pda/pda6502v2/docs/block.png

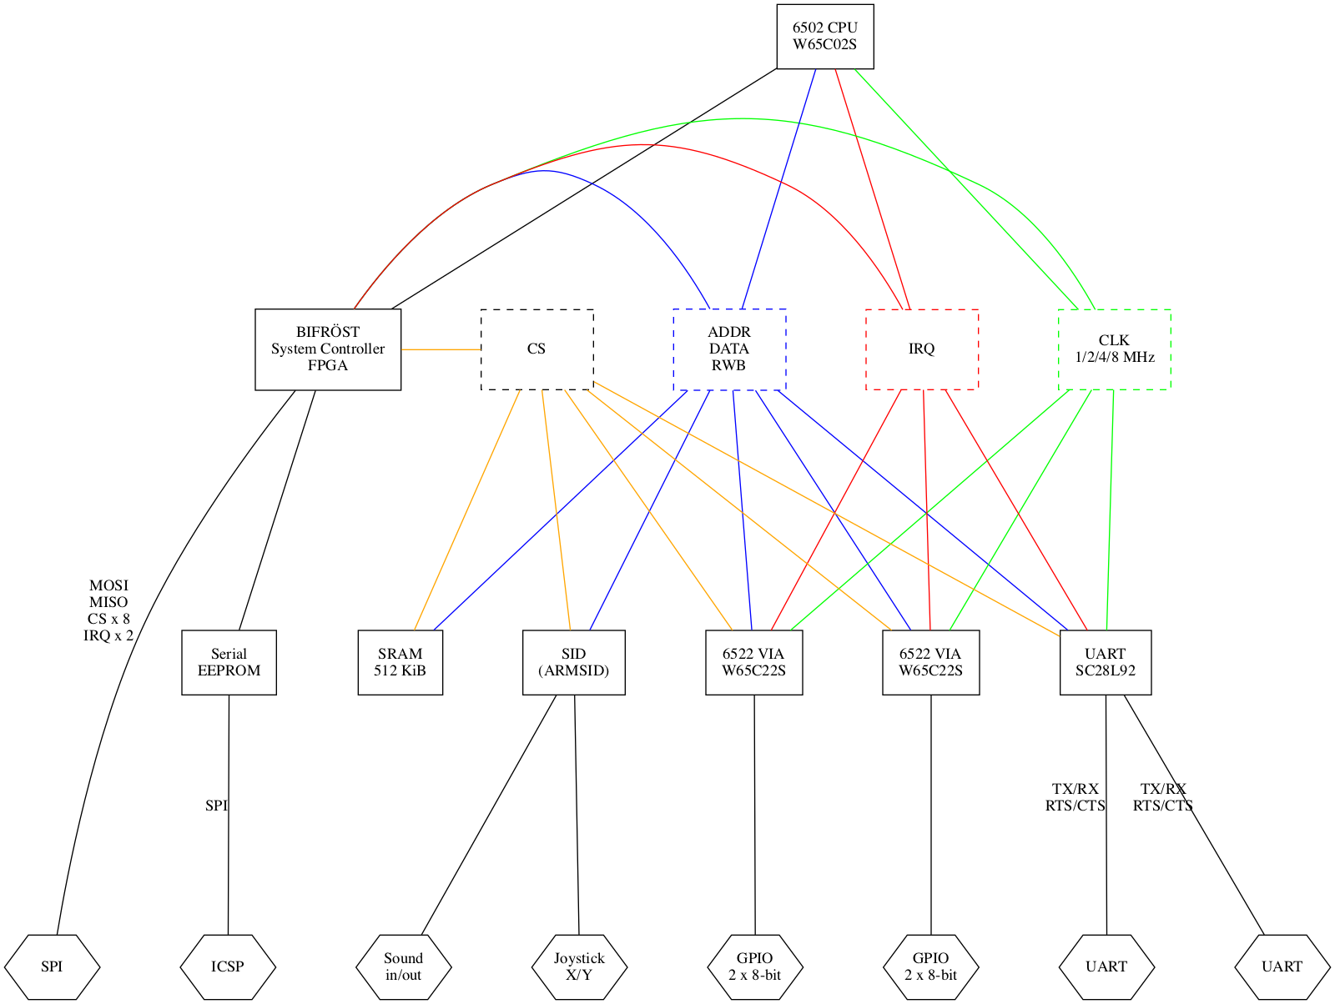
docs/block.png
