pda/pda6502v2/kicad/pda6502v2.kicad_pcb

## KiCad design kicad/pda6502v2.kicad_pcb (2023-10-16)

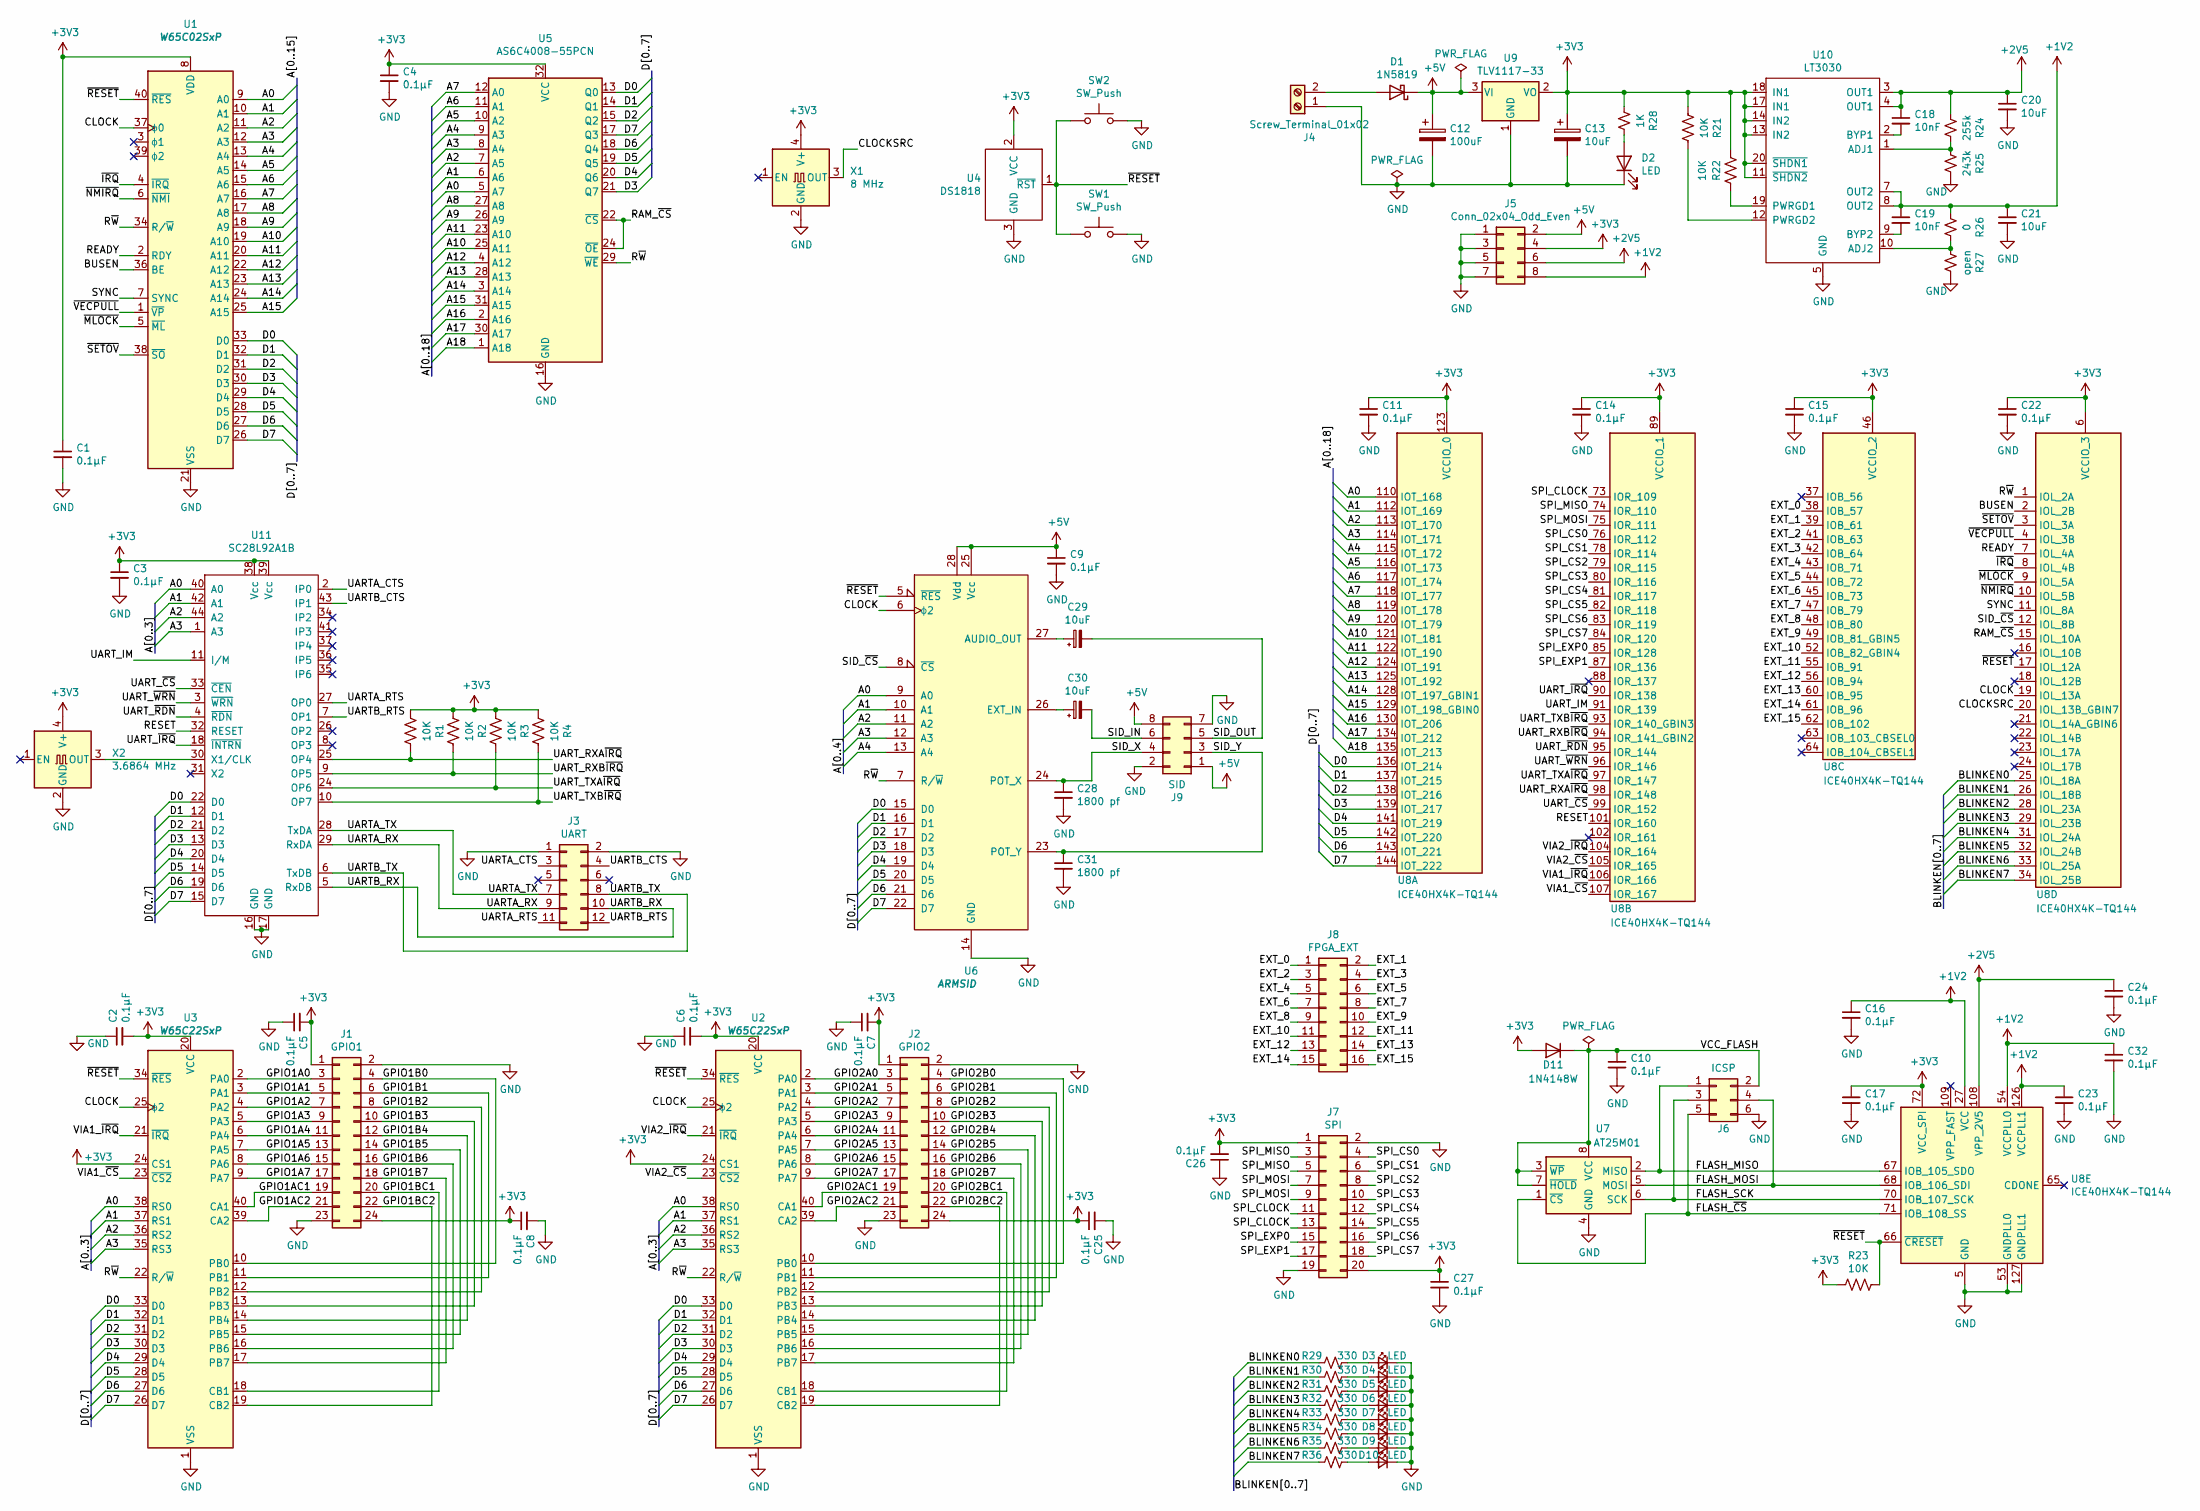
[picture p2: schematic pda6502v2.kicad_sch]

Parts:
C1, C2, C3, C4, C5, C6, C7, C8, C9, C10, C11, C14, C15, C16, C17, C22, C23, C24, C25, C26, C27, C32: 0.1μF; C_0805_2012Metric_Pad1.18x1.45mm_HandSolder
C12: 100uF; CP_Radial_D5.0mm_P2.00mm
C13: 10uF; CP_Radial_D5.0mm_P2.00mm
C18, C19: 10nF; C_0805_2012Metric_Pad1.18x1.45mm_HandSolder
C20, C21: 10uF; C_0805_2012Metric_Pad1.18x1.45mm_HandSolder
C28, C31: 1800 pf; C_0805_2012Metric_Pad1.18x1.45mm_HandSolder
C29, C30: 10uF; CP_EIA-3528-15_AVX-H_Pad1.50x2.35mm_HandSolder
D1: 1N5819; D_DO-41_SOD81_P10.16mm_Horizontal
D2: LED; LED_D3.0mm
D3, D4, D5, D6, D7, D8, D9, D10: LED; LED_0805_2012Metric_Pad1.15x1.40mm_HandSolder
D11: 1N4148W; D_SOD-123
J1: GPIO1; PinHeader_2x12_P2.54mm_Vertical
J2: GPIO2; PinHeader_2x12_P2.54mm_Vertical
J3: UART; PinHeader_2x06_P2.54mm_Vertical
J4: Screw_Terminal_01x02; TerminalBlock_Phoenix_MPT-0,5-2-2.54_1x02_P2.54mm_Horizontal
J5: Conn_02x04_Odd_Even; PinHeader_2x04_P2.54mm_Vertical
J6: ICSP; PinHeader_2x03_P2.54mm_Vertical
J7: SPI; PinHeader_2x10_P2.54mm_Vertical
J8: FPGA_EXT; PinHeader_2x08_P2.54mm_Vertical
J9: SID; PinHeader_2x04_P2.54mm_Vertical
R1, R2, R3, R4, R21, R22, R23: 10K; R_0805_2012Metric_Pad1.20x1.40mm_HandSolder
R24: 255k; R_0805_2012Metric_Pad1.20x1.40mm_HandSolder
R25: 243k; R_0805_2012Metric_Pad1.20x1.40mm_HandSolder
R26: 0; R_0805_2012Metric_Pad1.20x1.40mm_HandSolder
R27: open; R_0805_2012Metric_Pad1.20x1.40mm_HandSolder
R28: 1K; R_0805_2012Metric_Pad1.20x1.40mm_HandSolder
R29, R30, R31, R32, R33, R34, R35, R36: 330; R_0805_2012Metric_Pad1.20x1.40mm_HandSolder
SW1: SW_Push; SW_PUSH_6mm_H5mm
SW2: SW_Push; PinHeader_1x02_P2.54mm_Vertical
U1: W65C02SxP; DIP-40_W15.24mm
U2, U3: W65C22SxP; DIP-40_W15.24mm
U4: DS1818; SOT-23_Handsoldering
U5: AS6C4008-55PCN; DIP-32_W15.24mm
U6: ARMSID; DIP-28_W15.24mm_Socket
U7: AT25M01; SOIC-8_3.9x4.9mm_P1.27mm
U8: ICE40HX4K-TQ144; TQFP-144_20x20mm_P0.5mm
U9: TLV1117-33; SOT-223
U10: LT3030; HTSSOP-20-1EP_4.4x6.5mm_P0.65mm_EP2.85x4mm
U11: SC28L92A1B; PQFP-44_10x10mm_P0.8mm
X1: 8 MHz; Oscillator_SMD_EuroQuartz_XO53-4Pin_5.0x3.2mm
X2: 3.6864 MHz; Oscillator_SMD_EuroQuartz_XO53-4Pin_5.0x3.2mm

Connections:
+1V2: C16.1, C19.1, C21.1, C23.1, C32.1, J5.8, R26.2, U8.27 (VCC), U8.40 (VCC), U8.54 (VCCPLL0), U8.92 (VCC), U8.111 (VCC), U8.126 (VCCPLL1), U10.7 (OUT2), U10.8 (OUT2)
+2V5: C18.1, C20.1, C24.1, J5.6, R24.2, U8.108 (VPP_2V5), U10.3 (OUT1), U10.4 (OUT1)
+5V: C9.1, C12.1, D1.1 (K), J5.2, J9.1, J9.8, U6.25 (Vcc), U6.28 (Vdd), U9.3 (VI)
/A0: U1.9 (A0), U2.38 (RS0), U3.38 (RS0), U5.5 (A7), U6.9 (A0), U8.110 (IOT_168), U11.40 (A0)
/A1: U1.10 (A1), U2.37 (RS1), U3.37 (RS1), U5.6 (A6), U6.10 (A1), U8.112 (IOT_169), U11.42 (A1)
/A2: U1.11 (A2), U2.36 (RS2), U3.36 (RS2), U5.7 (A5), U6.11 (A2), U8.113 (IOT_170), U11.44 (A2)
/A3: U1.12 (A3), U2.35 (RS3), U3.35 (RS3), U5.8 (A4), U6.12 (A3), U8.114 (IOT_171), U11.1 (A3)
/A4: U1.13 (A4), U5.9 (A3), U6.13 (A4), U8.115 (IOT_172)
/A5: U1.14 (A5), U5.10 (A2), U8.116 (IOT_173)
/A6: U1.15 (A6), U5.11 (A1), U8.117 (IOT_174)
/A7: U1.16 (A7), U5.12 (A0), U8.118 (IOT_177)
/A8: U1.17 (A8), U5.27 (A8), U8.119 (IOT_178)
/A9: U1.18 (A9), U5.26 (A9), U8.120 (IOT_179)
/A10: U1.19 (A10), U5.25 (A11), U8.121 (IOT_181)
/A11: U1.20 (A11), U5.23 (A10), U8.122 (IOT_190)
/A12: U1.22 (A12), U5.4 (A12), U8.124 (IOT_191)
/A13: U1.23 (A13), U5.28 (A13), U8.125 (IOT_192)
/A14: U1.24 (A14), U5.3 (A14), U8.128 (IOT_197_GBIN1)
/A15: U1.25 (A15), U5.31 (A15), U8.129 (IOT_198_GBIN0)
/A16: U5.2 (A16), U8.130 (IOT_206)
/A17: U5.30 (A17), U8.134 (IOT_212)
/A18: U5.1 (A18), U8.135 (IOT_213)
/BLINKEN0: R29.2, U8.25 (IOL_18A)
/BLINKEN1: R30.2, U8.26 (IOL_18B)
/BLINKEN2: R31.2, U8.28 (IOL_23A)
/BLINKEN3: R32.2, U8.29 (IOL_23B)
/BLINKEN4: R33.2, U8.31 (IOL_24A)
/BLINKEN5: R34.2, U8.32 (IOL_24B)
/BLINKEN6: R35.2, U8.33 (IOL_25A)
/BLINKEN7: R36.2, U8.34 (IOL_25B)
/BUSEN: U1.36 (BE), U8.2 (IOL_2B)
/CLOCK: U1.37 (ϕ0), U2.25 (ϕ2), U3.25 (ϕ2), U6.6 (ϕ2), U8.19 (IOL_13A)
/CLOCKSRC: U8.20 (IOL_13B_GBIN7), X1.3 (OUT)
/D0: U1.33 (D0), U2.33 (D0), U3.33 (D0), U5.13 (Q0), U6.15 (D0), U8.136 (IOT_214), U11.22 (D0)
/D1: U1.32 (D1), U2.32 (D1), U3.32 (D1), U5.14 (Q1), U6.16 (D1), U8.137 (IOT_215), U11.12 (D1)
/D2: U1.31 (D2), U2.31 (D2), U3.31 (D2), U5.15 (Q2), U6.17 (D2), U8.138 (IOT_216), U11.21 (D2)
/D3: U1.30 (D3), U2.30 (D3), U3.30 (D3), U5.21 (Q7), U6.18 (D3), U8.139 (IOT_217), U11.13 (D3)
/D4: U1.29 (D4), U2.29 (D4), U3.29 (D4), U5.20 (Q6), U6.19 (D4), U8.141 (IOT_219), U11.20 (D4)
/D5: U1.28 (D5), U2.28 (D5), U3.28 (D5), U5.19 (Q5), U6.20 (D5), U8.142 (IOT_220), U11.14 (D5)
/D6: U1.27 (D6), U2.27 (D6), U3.27 (D6), U5.18 (Q4), U6.21 (D6), U8.143 (IOT_221), U11.19 (D6)
/D7: U1.26 (D7), U2.26 (D7), U3.26 (D7), U5.17 (Q3), U6.22 (D7), U8.144 (IOT_222), U11.15 (D7)
/EXT_0: J8.1, U8.38 (IOB_57)
/EXT_1: J8.2, U8.39 (IOB_61)
/EXT_2: J8.3, U8.41 (IOB_63)
/EXT_3: J8.4, U8.42 (IOB_64)
/EXT_4: J8.5, U8.43 (IOB_71)
/EXT_5: J8.6, U8.44 (IOB_72)
/EXT_6: J8.7, U8.45 (IOB_73)
/EXT_7: J8.8, U8.47 (IOB_79)
/EXT_8: J8.9, U8.48 (IOB_80)
/EXT_9: J8.10, U8.49 (IOB_81_GBIN5)
/EXT_10: J8.11, U8.52 (IOB_82_GBIN4)
/EXT_11: J8.12, U8.55 (IOB_91)
/EXT_12: J8.13, U8.56 (IOB_94)
/EXT_13: J8.14, U8.60 (IOB_95)
/EXT_14: J8.15, U8.61 (IOB_96)
/EXT_15: J8.16, U8.62 (IOB_102)
/FLASH_MISO: J6.1, U7.2 (MISO), U8.67 (IOB_105_SDO)
/FLASH_MOSI: J6.4, U7.5 (MOSI), U8.68 (IOB_106_SDI)
/FLASH_SCK: J6.3, U7.6 (SCK), U8.70 (IOB_107_SCK)
/FLASH_~CS: J6.5, U7.1 (~CS), U8.71 (IOB_108_SS)
/GPIO1A0: J1.3, U3.2 (PA0)
/GPIO1A1: J1.5, U3.3 (PA1)
/GPIO1A2: J1.7, U3.4 (PA2)
/GPIO1A3: J1.9, U3.5 (PA3)
/GPIO1A4: J1.11, U3.6 (PA4)
/GPIO1A5: J1.13, U3.7 (PA5)
/GPIO1A6: J1.15, U3.8 (PA6)
/GPIO1A7: J1.17, U3.9 (PA7)
/GPIO1AC1: J1.19, U3.40 (CA1)
/GPIO1AC2: J1.21, U3.39 (CA2)
/GPIO1B0: J1.4, U3.10 (PB0)
/GPIO1B1: J1.6, U3.11 (PB1)
/GPIO1B2: J1.8, U3.12 (PB2)
/GPIO1B3: J1.10, U3.13 (PB3)
/GPIO1B4: J1.12, U3.14 (PB4)
/GPIO1B5: J1.14, U3.15 (PB5)
/GPIO1B6: J1.16, U3.16 (PB6)
/GPIO1B7: J1.18, U3.17 (PB7)
/GPIO1BC1: J1.20, U3.18 (CB1)
/GPIO1BC2: J1.22, U3.19 (CB2)
/GPIO2A0: J2.3, U2.2 (PA0)
/GPIO2A1: J2.5, U2.3 (PA1)
/GPIO2A2: J2.7, U2.4 (PA2)
/GPIO2A3: J2.9, U2.5 (PA3)
/GPIO2A4: J2.11, U2.6 (PA4)
/GPIO2A5: J2.13, U2.7 (PA5)
/GPIO2A6: J2.15, U2.8 (PA6)
/GPIO2A7: J2.17, U2.9 (PA7)
/GPIO2AC1: J2.19, U2.40 (CA1)
/GPIO2AC2: J2.21, U2.39 (CA2)
/GPIO2B0: J2.4, U2.10 (PB0)
/GPIO2B1: J2.6, U2.11 (PB1)
/GPIO2B2: J2.8, U2.12 (PB2)
/GPIO2B3: J2.10, U2.13 (PB3)
/GPIO2B4: J2.12, U2.14 (PB4)
/GPIO2B5: J2.14, U2.15 (PB5)
/GPIO2B6: J2.16, U2.16 (PB6)
/GPIO2B7: J2.18, U2.17 (PB7)
/GPIO2BC1: J2.20, U2.18 (CB1)
/GPIO2BC2: J2.22, U2.19 (CB2)
/RAM_~CS: U5.22 (~CS), U5.24 (~OE), U8.15 (IOL_10A)
/READY: U1.2 (RDY), U8.7 (IOL_4A)
/RESET: U8.101 (IOR_160), U11.32 (RESET)
/R~W: U1.34 (R/~W), U2.22 (R/~W), U3.22 (R/~W), U5.29 (~WE), U6.7 (R/~W), U8.1 (IOL_2A)
/SID_IN: C30.2, J9.6
/SID_OUT: C29.2, J9.5
/SID_X: C28.1, J9.4, U6.24 (POT_X)
/SID_Y: C31.1, J9.3, U6.23 (POT_Y)
/SID_~CS: U6.8 (~CS), U8.12 (IOL_8B)
/SPI_CLOCK: J7.11, J7.13, U8.73 (IOR_109)
/SPI_CS0: J7.4, U8.76 (IOR_112)
/SPI_CS1: J7.6, U8.78 (IOR_114)
/SPI_CS2: J7.8, U8.79 (IOR_115)
/SPI_CS3: J7.10, U8.80 (IOR_116)
/SPI_CS4: J7.12, U8.81 (IOR_117)
/SPI_CS5: J7.14, U8.82 (IOR_118)
/SPI_CS6: J7.16, U8.83 (IOR_119)
/SPI_CS7: J7.18, U8.84 (IOR_120)
/SPI_EXP0: J7.15, U8.85 (IOR_128)
/SPI_EXP1: J7.17, U8.87 (IOR_136)
/SPI_MISO: J7.3, J7.5, U8.74 (IOR_110)
/SPI_MOSI: J7.7, J7.9, U8.75 (IOR_111)
/SYNC: U1.7 (SYNC), U8.11 (IOL_8A)
/UARTA_CTS: J3.3, U11.2 (IP0)
/UARTA_RTS: J3.11, U11.27 (OP0)
/UARTA_RX: J3.9, U11.29 (RxDA)
/UARTA_TX: J3.7, U11.28 (TxDA)
/UARTB_CTS: J3.4, U11.43 (IP1)
/UARTB_RTS: J3.12, U11.7 (OP1)
/UARTB_RX: J3.10, U11.5 (RxDB)
/UARTB_TX: J3.8, U11.6 (TxDB)
/UART_IM: U8.91 (IOR_139), U11.11 (I/M)
/UART_RXA~IRQ: R1.1, U8.98 (IOR_148), U11.25 (OP4)
/UART_RXB~IRQ: R2.1, U8.94 (IOR_141_GBIN2), U11.9 (OP5)
/UART_TXA~IRQ: R3.1, U8.97 (IOR_147), U11.24 (OP6)
/UART_TXB~IRQ: R4.1, U8.93 (IOR_140_GBIN3), U11.10 (OP7)
/UART_~CS: U8.99 (IOR_152), U11.33 (~CEN)
/UART_~IRQ: U8.90 (IOR_138), U11.18 (~INTRN)
/UART_~RDN: U8.95 (IOR_144), U11.4 (~RDN)
/UART_~WRN: U8.96 (IOR_146), U11.3 (~WRN)
/VCC_FLASH: C10.1, D11.1 (K), J6.2, U7.3 (~WP), U7.7 (~HOLD), U7.8 (VCC)
/VIA1_~CS: U3.23 (~CS2), U8.107 (IOR_167)
/VIA1_~IRQ: U3.21 (~IRQ), U8.106 (IOR_166)
/VIA2_~CS: U2.23 (~CS2), U8.105 (IOR_165)
/VIA2_~IRQ: U2.21 (~IRQ), U8.104 (IOR_164)
/~IRQ: U1.4 (~IRQ), U8.8 (IOL_4B)
/~MLOCK: U1.5 (~ML), U8.9 (IOL_5A)
/~NMIRQ: U1.6 (~NMI), U8.10 (IOL_5B)
/~RESET: R23.1, SW1.1, SW2.2, U1.40 (~RES), U2.34 (~RES), U3.34 (~RES), U4.1 (~RST), U6.5 (~RES), U8.17 (IOL_12A), U8.66 (~CRESET)
/~SETOV: U1.38 (~SO), U8.3 (IOL_3A)
/~VECPULL: U1.1 (~VP), U8.4 (IOL_3B)
unnamed: C18.2, U10.2 (BYP1)
unnamed: C19.2, U10.9 (BYP2)
unnamed: C29.1, U6.27 (AUDIO_OUT)
unnamed: C30.1, U6.26 (EXT_IN)
unnamed: D1.2 (A), J4.2
unnamed: D2.2 (A), R28.1
unnamed: D3.2 (A), R29.1
unnamed: D4.2 (A), R30.1
unnamed: D5.2 (A), R31.1
unnamed: D6.2 (A), R32.1
unnamed: D7.2 (A), R33.1
unnamed: D8.2 (A), R34.1
unnamed: D9.2 (A), R35.1
unnamed: D10.2 (A), R36.1
unnamed: R21.1, U10.12 (PWRGD2)
unnamed: R22.1, U10.19 (PWRGD1)
unnamed: R24.1, R25.2, U10.1 (ADJ1)
unnamed: R26.1, R27.2, U10.10 (ADJ2)
unnamed: U11.30 (X1/CLK), X2.3 (OUT)

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
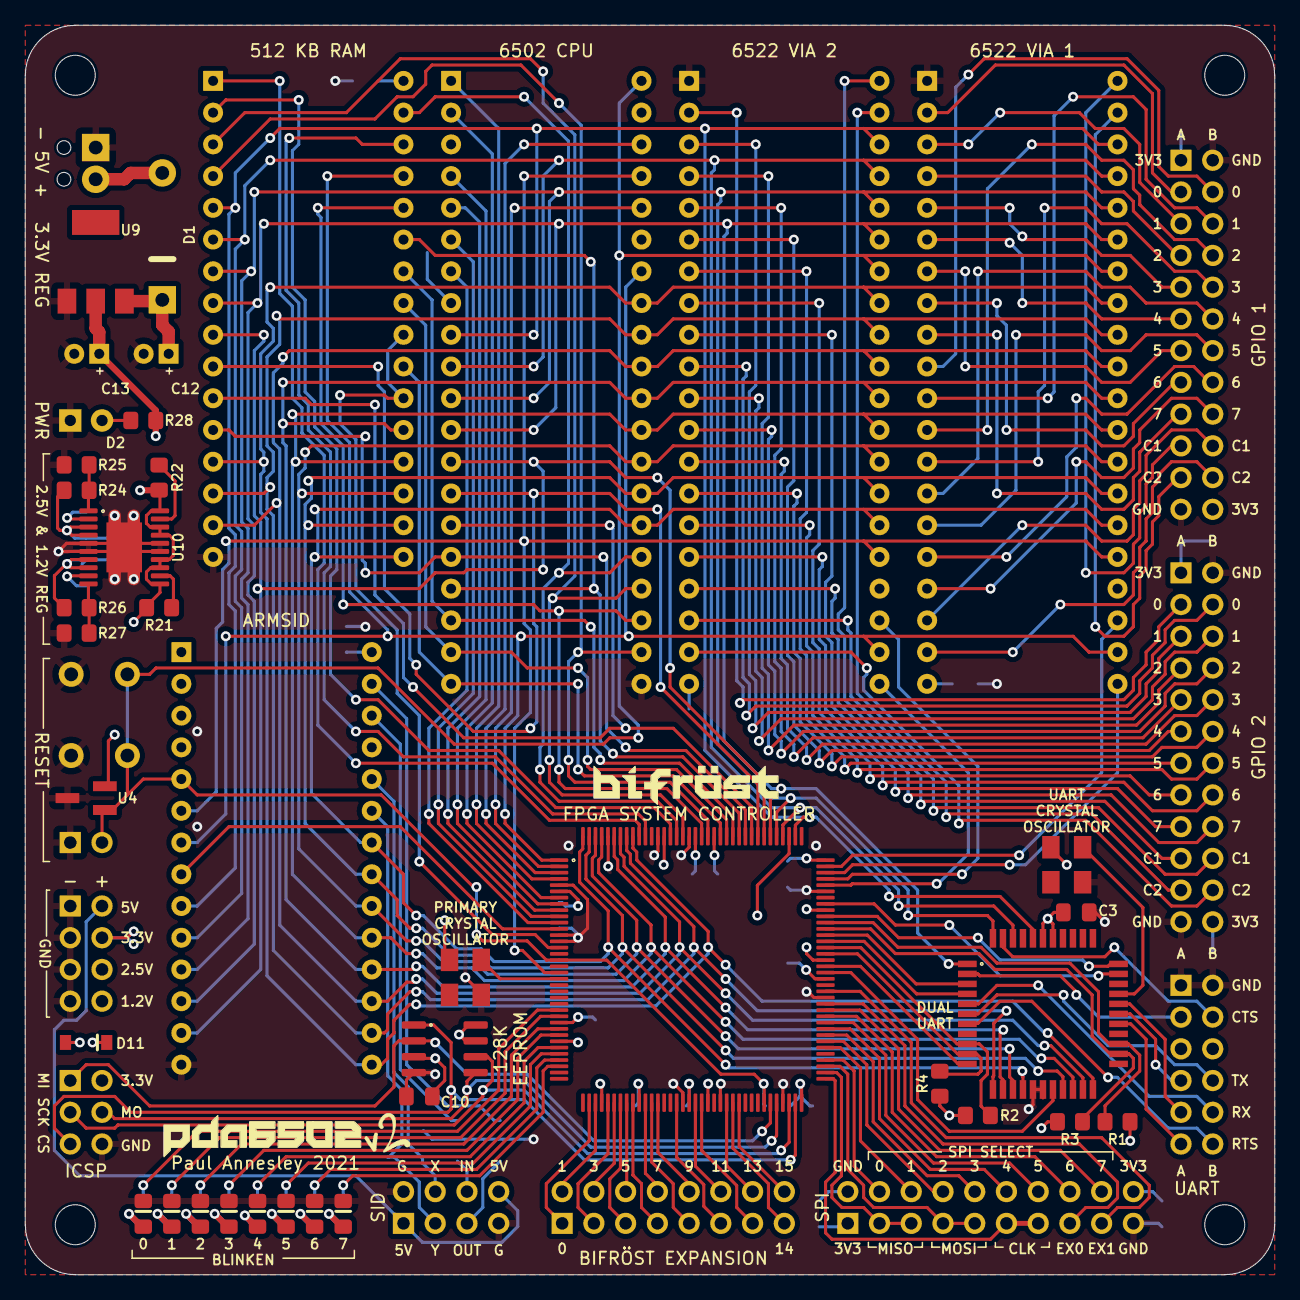
[picture p3: board pda6502v2.kicad_pcb from above]

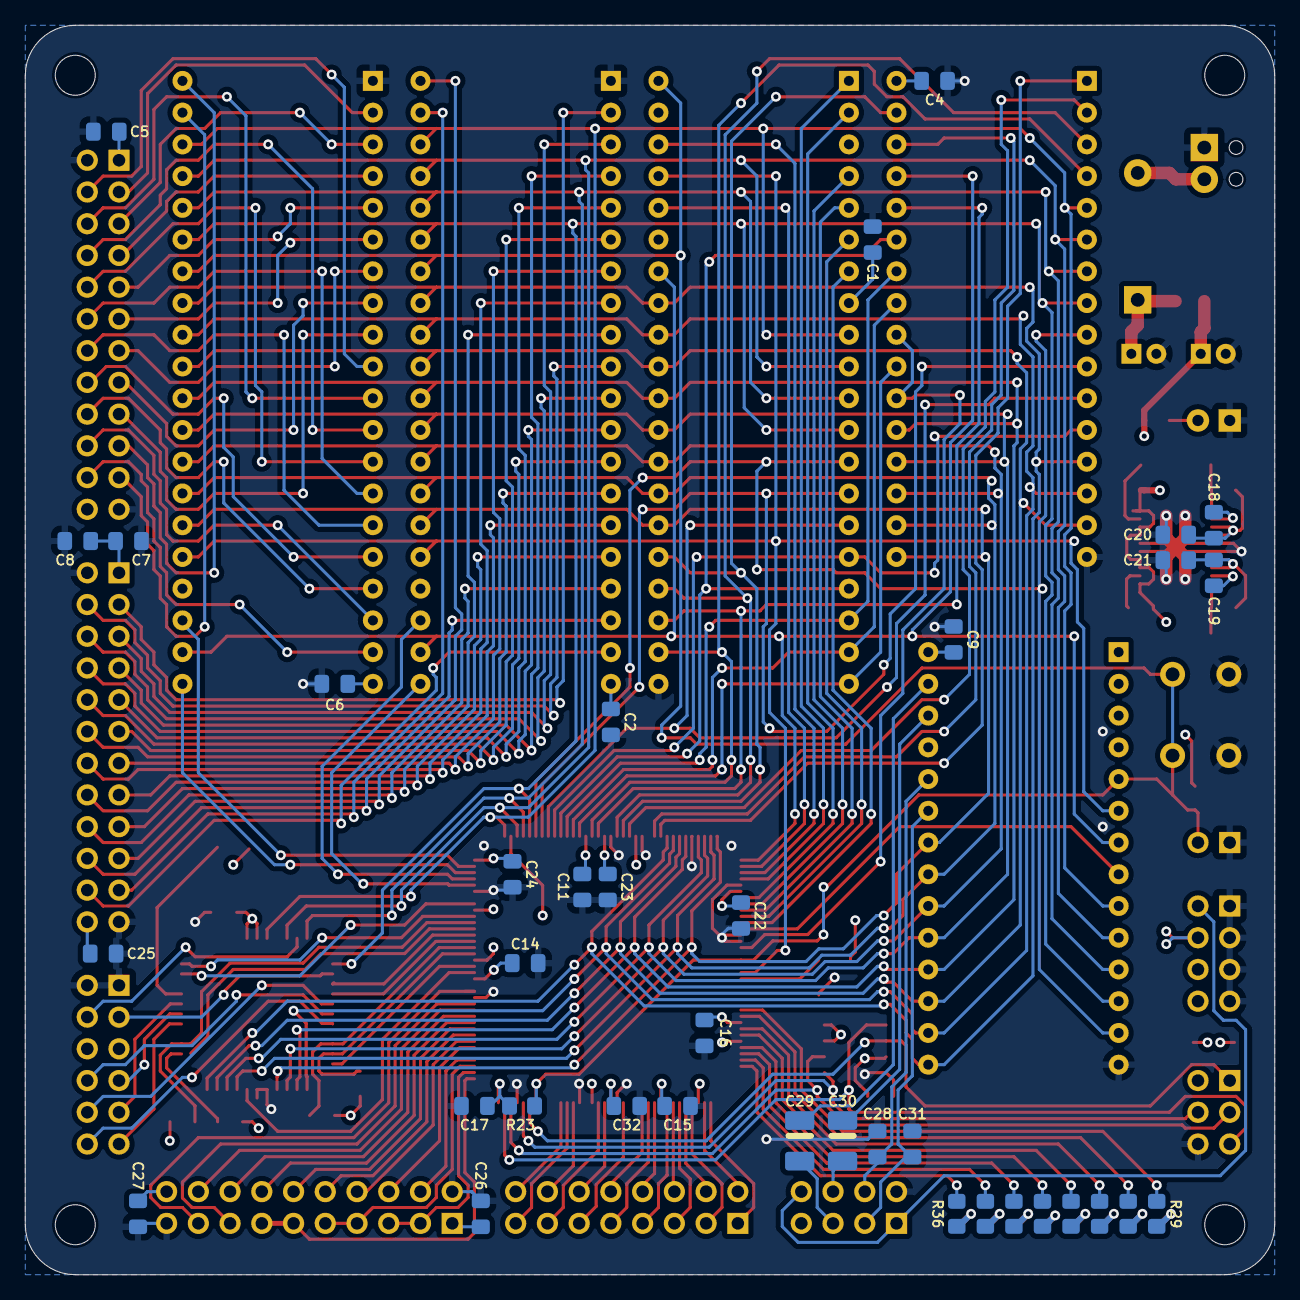
[picture p4: board pda6502v2.kicad_pcb from below]

Board: 4 copper layers, 100.0 x 100.0 mm, 87 parts (37 on the bottom side), 173 nets.
