pda/pda6502v2/emu/src/asm.rs

use std::collections::HashMap;
use std::fmt;

use crate::isa;
use crate::isa::{AddressMode, Mnemonic, OpValue, Opcode};

#[cfg(test)]
mod tests {
    use super::*;

    #[test]
    fn it_assembles_single_nop() {
        let mut asm = Assembler::new();
        assert_eq!(asm.nop().assemble().unwrap(), vec![0xEA]);
    }

    #[test]
    fn it_assembles_tiny_program_with_absolute_operand() {
        let mut asm = Assembler::new();
        asm.nop().nop().jmp(Operand::Abs(Addr::Literal(0x1234)));
        println!("{}", asm);
        assert_eq!(asm.assemble().unwrap(), vec![0xEA, 0xEA, 0x4C, 0x34, 0x12]);
    }

    #[test]
    fn it_assembles_labels() {
        let mut asm = Assembler::new();
        asm.org(0x1000)
            .label("foo")
            .jmp(Operand::Abs(label("bar")))
            .label("bar")
            .jmp(Operand::Abs(label("foo")));
        println!("{}", asm);
        assert_eq!(
            asm.assemble().unwrap(),
            vec![0x4C, 0x03, 0x10, 0x4C, 0x00, 0x10]
        );
    }

    #[test]
    #[should_panic(expected = "IllegalAddressMode(Jmp, Relative)")]
    fn it_errors_on_illegal_address_mode() {
        let mut asm = Assembler::new();
        asm.jmp(Operand::Rel(BranchTarget::Offset(0)))
            .assemble()
            .unwrap();
    }

    #[test]
    fn it_branches_to_nearby_label() {
        let mut asm = Assembler::new();
        asm.org(0x1000)
            .label("foo")
            .bcc(Operand::Rel(branch("bar")))
            .nop()
            .label("bar")
            .bcc(Operand::Rel(branch("foo")));
        println!("{}", asm);
        assert_eq!(asm.assemble().unwrap(), vec![0x90, 0x01, 0xEA, 0x90, 0xFB]);
    }

    #[test]
    #[should_panic(expected = "RelativeAddressOutOfRange(-131)")]
    fn it_cannot_branch_to_distant_label() {
        let mut asm = Assembler::new();
        asm.org(0x2000).label("start");
        for _ in 0..43 {
            asm.jmp(Operand::Abs(val(0x0000))); // 129 bytes of program
        }
        asm.bcc(Operand::Rel(branch("start")));
        asm.assemble().unwrap();
    }

    #[test]
    fn it_lists_with_out_of_range_label() {
        let mut asm = Assembler::new();
        asm.org(0x2000).label("start");
        for _ in 0..43 {
            asm.jmp(Operand::Abs(val(0x0000))); // 129 bytes of program
        }
        asm.bcc(Operand::Rel(branch("start")));
        println!("{}", asm.listing().unwrap());
    }
}

pub struct Assembler {
    pub org: u16,
    lines: Vec<Line>,
    next_label: Option<String>,
    opcode_map: isa::OpcodeByMnemonicAndAddressMode,
}

impl Assembler {
    pub fn new() -> Assembler {
        Self {
            org: 0x0000,
            lines: Vec::new(),
            next_label: None,
            opcode_map: isa::OpcodeByMnemonicAndAddressMode::build(),
        }
    }

    // TODO: consistently use -> &mut Self everywhere
    pub fn org(&mut self, addr: u16) -> &mut Self {
        self.org = addr;
        self
    }

    pub fn label(&mut self, l: &str) -> &mut Self {
        self.next_label = Some(l.to_string());
        self
    }

    pub fn data(&mut self, d: Vec<u8>) -> &mut Self {
        self.lines.push(Line::Data(DataLine {
            label: self.next_label.take(),
            data: d,
        }));
        self
    }

    // ----------------------------------------
    // Instructions

    pub fn adc(&mut self, op: Operand) -> &mut Self {
        self.push_instruction(Mnemonic::Adc, op)
    }

    pub fn and(&mut self, op: Operand) -> &mut Self {
        self.push_instruction(Mnemonic::And, op)
    }

    pub fn asl(&mut self, op: Operand) -> &mut Self {
        self.push_instruction(Mnemonic::Asl, op)
    }

    pub fn bcc(&mut self, op: Operand) -> &mut Self {
        self.push_instruction(Mnemonic::Bcc, op)
    }

    pub fn bcs(&mut self, op: Operand) -> &mut Self {
        self.push_instruction(Mnemonic::Bcs, op)
    }

    pub fn beq(&mut self, op: Operand) -> &mut Self {
        self.push_instruction(Mnemonic::Beq, op)
    }

    pub fn bit(&mut self, op: Operand) -> &mut Self {
        self.push_instruction(Mnemonic::Bit, op)
    }

    pub fn bmi(&mut self, op: Operand) -> &mut Self {
        self.push_instruction(Mnemonic::Bmi, op)
    }

    pub fn bne(&mut self, op: Operand) -> &mut Self {
        self.push_instruction(Mnemonic::Bne, op)
    }

    pub fn bpl(&mut self, op: Operand) -> &mut Self {
        self.push_instruction(Mnemonic::Bpl, op)
    }

    pub fn brk(&mut self) -> &mut Self {
        self.push_instruction(Mnemonic::Brk, Operand::Impl)
    }

    pub fn bvc(&mut self, op: Operand) -> &mut Self {
        self.push_instruction(Mnemonic::Bvc, op)
    }

    pub fn bvs(&mut self, op: Operand) -> &mut Self {
        self.push_instruction(Mnemonic::Bvs, op)
    }

    pub fn clc(&mut self) -> &mut Self {
        self.push_instruction(Mnemonic::Clc, Operand::Impl)
    }

    pub fn cld(&mut self) -> &mut Self {
        self.push_instruction(Mnemonic::Cld, Operand::Impl)
    }

    pub fn cli(&mut self) -> &mut Self {
        self.push_instruction(Mnemonic::Cli, Operand::Impl)
    }

    pub fn clv(&mut self) -> &mut Self {
        self.push_instruction(Mnemonic::Clv, Operand::Impl)
    }

    pub fn cmp(&mut self, op: Operand) -> &mut Self {
        self.push_instruction(Mnemonic::Cmp, op)
    }

    pub fn cpx(&mut self, op: Operand) -> &mut Self {
        self.push_instruction(Mnemonic::Cpx, op)
    }

    pub fn cpy(&mut self, op: Operand) -> &mut Self {
        self.push_instruction(Mnemonic::Cpy, op)
    }

    pub fn dec(&mut self, op: Operand) -> &mut Self {
        self.push_instruction(Mnemonic::Dec, op)
    }

    pub fn dex(&mut self) -> &mut Self {
        self.push_instruction(Mnemonic::Dex, Operand::Impl)
    }

    pub fn dey(&mut self) -> &mut Self {
        self.push_instruction(Mnemonic::Dey, Operand::Impl)
    }

    pub fn eor(&mut self, op: Operand) -> &mut Self {
        self.push_instruction(Mnemonic::Eor, op)
    }

    pub fn inc(&mut self, op: Operand) -> &mut Self {
        self.push_instruction(Mnemonic::Inc, op)
    }

    pub fn inx(&mut self) -> &mut Self {
        self.push_instruction(Mnemonic::Inx, Operand::Impl)
    }

    pub fn iny(&mut self) -> &mut Self {
        self.push_instruction(Mnemonic::Iny, Operand::Impl)
    }

    pub fn jmp(&mut self, op: Operand) -> &mut Self {
        self.push_instruction(Mnemonic::Jmp, op)
    }

    pub fn jsr(&mut self, op: Operand) -> &mut Self {
        self.push_instruction(Mnemonic::Jsr, op)
    }

    pub fn lda(&mut self, op: Operand) -> &mut Self {
        self.push_instruction(Mnemonic::Lda, op)
    }

    pub fn ldx(&mut self, op: Operand) -> &mut Self {
        self.push_instruction(Mnemonic::Ldx, op)
    }

    pub fn ldy(&mut self, op: Operand) -> &mut Self {
        self.push_instruction(Mnemonic::Ldy, op)
    }

    pub fn lsr(&mut self, op: Operand) -> &mut Self {
        self.push_instruction(Mnemonic::Lsr, op)
    }

    pub fn nop(&mut self) -> &mut Self {
        self.push_instruction(Mnemonic::Nop, Operand::Impl)
    }

    pub fn ora(&mut self, op: Operand) -> &mut Self {
        self.push_instruction(Mnemonic::Ora, op)
    }

    pub fn pha(&mut self) -> &mut Self {
        self.push_instruction(Mnemonic::Pha, Operand::Impl)
    }

    pub fn php(&mut self) -> &mut Self {
        self.push_instruction(Mnemonic::Php, Operand::Impl)
    }

    pub fn pla(&mut self) -> &mut Self {
        self.push_instruction(Mnemonic::Pla, Operand::Impl)
    }

    pub fn plp(&mut self) -> &mut Self {
        self.push_instruction(Mnemonic::Plp, Operand::Impl)
    }

    pub fn rol(&mut self, op: Operand) -> &mut Self {
        self.push_instruction(Mnemonic::Rol, op)
    }

    pub fn ror(&mut self, op: Operand) -> &mut Self {
        self.push_instruction(Mnemonic::Ror, op)
    }

    pub fn rti(&mut self) -> &mut Self {
        self.push_instruction(Mnemonic::Rti, Operand::Impl)
    }

    pub fn rts(&mut self) -> &mut Self {
        self.push_instruction(Mnemonic::Rts, Operand::Impl)
    }

    pub fn sbc(&mut self, op: Operand) -> &mut Self {
        self.push_instruction(Mnemonic::Sbc, op)
    }

    pub fn sec(&mut self) -> &mut Self {
        self.push_instruction(Mnemonic::Sec, Operand::Impl)
    }

    pub fn sed(&mut self) -> &mut Self {
        self.push_instruction(Mnemonic::Sed, Operand::Impl)
    }

    pub fn sei(&mut self) -> &mut Self {
        self.push_instruction(Mnemonic::Sei, Operand::Impl)
    }

    pub fn sta(&mut self, op: Operand) -> &mut Self {
        self.push_instruction(Mnemonic::Sta, op)
    }

    pub fn stx(&mut self, op: Operand) -> &mut Self {
        self.push_instruction(Mnemonic::Stx, op)
    }

    pub fn sty(&mut self, op: Operand) -> &mut Self {
        self.push_instruction(Mnemonic::Sty, op)
    }

    pub fn tax(&mut self) -> &mut Self {
        self.push_instruction(Mnemonic::Tax, Operand::Impl)
    }

    pub fn tay(&mut self) -> &mut Self {
        self.push_instruction(Mnemonic::Tay, Operand::Impl)
    }

    pub fn tsx(&mut self) -> &mut Self {
        self.push_instruction(Mnemonic::Tsx, Operand::Impl)
    }

    pub fn txa(&mut self) -> &mut Self {
        self.push_instruction(Mnemonic::Txa, Operand::Impl)
    }

    pub fn txs(&mut self) -> &mut Self {
        self.push_instruction(Mnemonic::Txs, Operand::Impl)
    }

    pub fn tya(&mut self) -> &mut Self {
        self.push_instruction(Mnemonic::Tya, Operand::Impl)
    }

    // ----------------------------------------

    pub fn assemble(&self) -> Result<Vec<u8>, Error> {
        let mut bin: Vec<u8> = Vec::new();

        let labtab = self.build_label_table();

        let mut addr = self.org;
        for line in self.lines.iter() {
            addr += line.size();
            match line {
                Line::Instruction(line) => {
                    bin.push(line.instruction?.code);
                    match op_value(addr, &line.operand, &labtab)? {
                        OpValue::None => {}
                        OpValue::U8(x) => bin.push(x),
                        OpValue::U16(x) => {
                            bin.push(x as u8);
                            bin.push((x >> 8) as u8);
                        }
                    };
                }
                Line::Data(line) => bin.extend(&line.data),
            }
        }
        Ok(bin)
    }

    pub fn listing(&self) -> Result<String, Error> {
        use std::fmt::Write;
        let mut f = String::new();

        let labtab = self.build_label_table();

        writeln!(f, "* = ${:04X}", self.org)?;
        let mut addr = self.org;
        for line in self.lines.iter() {
            let base_addr = addr;
            addr += line.size();
            line.fmt(&mut f, base_addr, addr, &labtab)?;
        }
        Ok(f)
    }

    pub fn print_listing(&mut self) -> &mut Self {
        println!("{}", self.listing().unwrap());
        self
    }

    fn push_instruction(&mut self, mnemonic: Mnemonic, op: Operand) -> &mut Self {
        self.lines.push(Line::Instruction(InstructionLine {
            label: self.next_label.take(),
            instruction: self.opcode_map.get(mnemonic, op.mode()).map_err(Into::into),
            operand: op,
            comment: None,
        }));
        self
    }

    fn build_label_table(&self) -> HashMap<&str, u16> {
        let mut labtab: HashMap<&str, u16> = HashMap::new();
        let mut addr = self.org;
        for line in self.lines.iter() {
            if let Some(l) = &line.label() {
                labtab.insert(l, addr);
            }
            addr += line.size();
        }
        labtab
    }
}

impl fmt::Display for Assembler {
    fn fmt(&self, f: &mut fmt::Formatter<'_>) -> fmt::Result {
        write!(f, "{}", self.listing().unwrap())
    }
}

impl fmt::Display for Operand {
    fn fmt(&self, f: &mut fmt::Formatter<'_>) -> fmt::Result {
        use Operand::*;
        match self {
            A => write!(f, "A"),
            Abs(x) => write!(f, "{}", x),
            AbsX(x) => write!(f, "{},X", x),
            AbsY(x) => write!(f, "{},Y", x),
            Imm(x) => write!(f, "${:02X}", x),
            Impl => Ok(()),
            Ind(x) => write!(f, "({})", x),
            XInd(x) => write!(f, "(${:02X},X)", x),
            IndY(x) => write!(f, "(${:02X}),Y", x),
            Rel(x) => write!(f, "{}", x),
            Z(x) => write!(f, "${:02X}", x),
            ZX(x) => write!(f, "${:02X},X", x),
            ZY(x) => write!(f, "${:02X},Y", x),
        }
    }
}

impl fmt::Display for Addr {
    fn fmt(&self, f: &mut fmt::Formatter<'_>) -> fmt::Result {
        match self {
            Addr::Literal(a) => write!(f, "${:04X}", a),
            Addr::Label(l) => write!(f, "{}", l),
        }
    }
}

impl fmt::Display for BranchTarget {
    fn fmt(&self, f: &mut fmt::Formatter<'_>) -> fmt::Result {
        match self {
            BranchTarget::Offset(x) => write!(f, "{}", x),
            BranchTarget::Label(l) => write!(f, "{}", l),
        }
    }
}

#[derive(Debug)]
pub enum Line {
    Instruction(InstructionLine),
    Data(DataLine),
}

#[derive(Debug)]
pub struct InstructionLine {
    pub label: Option<String>,
    pub instruction: Result<Opcode, Error>,
    pub operand: Operand,
    pub comment: Option<String>,
}

#[derive(Debug)]
pub struct DataLine {
    label: Option<String>,
    data: Vec<u8>,
}

impl Line {
    fn label(&self) -> &Option<String> {
        match self {
            Line::Instruction(line) => &line.label,
            Line::Data(line) => &line.label,
        }
    }

    fn size(&self) -> u16 {
        match self {
            Line::Instruction(line) => line.operand.length() as u16 + 1,
            Line::Data(line) => line.data.len().try_into().unwrap(),
        }
    }

    pub fn fmt(
        &self,
        f: &mut String,
        base_addr: u16,
        addr: u16,
        labtab: &HashMap<&str, u16>,
    ) -> Result<(), Error> {
        use std::fmt::Write;

        match self {
            Line::Instruction(line) => {
                let instruction = line.instruction.unwrap();
                let mut err: Option<Error> = None;
                let ophex = match op_value(addr, &line.operand, &labtab) {
                    Ok(x) => match x {
                        OpValue::None => String::new(),
                        OpValue::U8(x) => format!("{:02X}", x),
                        OpValue::U16(x) => format!("{:02X} {:02X}", x & 0xFF, (x >> 8)),
                    },
                    Err(e) => {
                        err = Some(e);
                        format!("?? ??")
                    }
                };
                let label = match &line.label {
                    Some(label) => format!("{}:", label),
                    None => String::from(""),
                };
                let op_prefix = match instruction.mode {
                    AddressMode::Immediate => "#",
                    _ => "",
                };
                let err_string = match err {
                    Some(e) => format!(" ; {e:?}"),
                    None => String::from(""),
                };
                let comment = match &line.comment {
                    Some(c) => format!(" ; {c}"),
                    None => String::new(),
                };
                writeln!(
                    f,
                    "{:04X} | {:02X} {:5} | {:16} {} {}{}{}{}",
                    base_addr,
                    instruction.code,
                    ophex,
                    label,
                    instruction.mnemonic,
                    op_prefix,
                    line.operand,
                    err_string,
                    comment,
                )?;
            }
            Line::Data(line) => {
                let label = match &line.label {
                    Some(label) => format!("{}:", label),
                    None => String::from(""),
                };
                writeln!(f, "                  {:16}", label)?;
                let mut addr = base_addr;
                for linechunk in line.data.chunks(16) {
                    let hex = linechunk
                        .chunks(8)
                        .map(|half| {
                            half.iter()
                                .map(|x| format!("{:02X}", x))
                                .collect::<Vec<String>>()
                                .join(" ")
                        })
                        .collect::<Vec<String>>()
                        .join("  ");

                    let ascii: String = linechunk
                        .iter()
                        .map(|&x| if x >= 32 && x <= 126 { x as char } else { '.' })
                        .collect();

                    writeln!(f, "{:04X}  {:49} |{}|", addr, hex, ascii)?;

                    addr += linechunk.len() as u16;
                }
            }
        }

        Ok(())
    }
}

// Opcode Operands
#[derive(Debug)]
pub enum Operand {
    A,
    Abs(Addr),
    AbsX(Addr),
    AbsY(Addr),
    Imm(u8),
    Impl,
    Ind(Addr),
    XInd(u8),
    IndY(u8),
    Rel(BranchTarget),
    Z(u8),
    ZX(u8),
    ZY(u8),
}

impl Operand {
    fn mode(&self) -> AddressMode {
        match self {
            Operand::A => AddressMode::Accumulator,
            Operand::Abs(_) => AddressMode::Absolute,
            Operand::AbsX(_) => AddressMode::AbsoluteX,
            Operand::AbsY(_) => AddressMode::AbsoluteY,
            Operand::Imm(_) => AddressMode::Immediate,
            Operand::Impl => AddressMode::Implied,
            Operand::Ind(_) => AddressMode::Indirect,
            Operand::XInd(_) => AddressMode::XIndirect,
            Operand::IndY(_) => AddressMode::IndirectY,
            Operand::Rel(_) => AddressMode::Relative,
            Operand::Z(_) => AddressMode::Zeropage,
            Operand::ZX(_) => AddressMode::ZeropageX,
            Operand::ZY(_) => AddressMode::ZeropageY,
        }
    }

    fn length(&self) -> u16 {
        isa::operand_length(self.mode())
    }
}

#[derive(Debug)]
pub enum Addr {
    Literal(u16),
    Label(String),
}

// shorthand for a literal/numeric address, as opposed to a labelled address.
pub fn val(v: u16) -> Addr {
    Addr::Literal(v)
}

// shorthand for a labelled address, as opposed to a literal (numeric) address.
pub fn label(s: &str) -> Addr {
    Addr::Label(s.to_string())
}

#[derive(Debug)]
#[allow(unused)]
pub enum BranchTarget {
    Offset(i8),
    Label(String),
}

// shorthand for a nearby labelled branch target
pub fn branch(s: &str) -> BranchTarget {
    BranchTarget::Label(s.to_string())
}

#[derive(Debug, Clone, Copy)]
pub enum Error {
    IllegalAddressMode(Mnemonic, AddressMode),
    RelativeAddressOutOfRange(i16),
    LabelNotFound, // TODO: include label string
    Fmt(fmt::Error),
}

impl From<fmt::Error> for Error {
    fn from(err: fmt::Error) -> Self {
        Error::Fmt(err)
    }
}

impl From<isa::Error> for Error {
    fn from(err: isa::Error) -> Self {
        match err {
            isa::Error::IllegalAddressMode(m, am) => Error::IllegalAddressMode(m, am),
        }
    }
}

fn op_value(addr: u16, op: &Operand, labtab: &HashMap<&str, u16>) -> Result<OpValue, Error> {
    use Operand::*;
    match op {
        A | Impl => Ok(OpValue::None),
        Abs(x) | AbsX(x) | AbsY(x) | Ind(x) => match x {
            Addr::Literal(x) => Ok(OpValue::U16(*x)),
            Addr::Label(x) => match labtab.get(x.as_str()) {
                Some(addr) => Ok(OpValue::U16(*addr)),
                None => Err(Error::LabelNotFound),
            },
        },
        Rel(x) => match x {
            BranchTarget::Offset(x) => Ok(OpValue::U8(*x as u8)),
            BranchTarget::Label(x) => {
                let target_addr = match labtab.get(x.as_str()) {
                    Some(addr) => *addr,
                    None => return Err(Error::LabelNotFound),
                };
                let rel16: i16 = target_addr.wrapping_sub(addr) as i16;
                let rel8: i8 = match rel16.try_into() {
                    Ok(x) => x,
                    Err(_) => {
                        return Err(Error::RelativeAddressOutOfRange(rel16));
                    }
                };
                Ok(OpValue::U8(rel8 as u8))
            }
        },
        Imm(x) | XInd(x) | IndY(x) | Z(x) | ZX(x) | ZY(x) => Ok(OpValue::U8(*x)),
    }
}
