pda/pda6502v2/(commit log)

2017-03-19 hardware: new blank KiCad project.
    [pda6502v2.kicad_pcb, pda6502v2.sch]
2017-03-19 KiCad.gitignore from github/gitignore
2017-03-19 pda6502v2 KiCad library with SAMD21J18A-AU
2017-03-20 Xilinx CoolRunner-II XC2C64A VQ-44 CPLD in library.
    Based on Dangerous Prototypes' converted-from-Eagle KiCad lib.
2017-03-31 hardware: WIP: glue schematic (CPLD address decode).
    [glue.sch, pda6502v2.sch]
2017-04-10 hardware: delete WIP on VQ44 "glue" CPLD.
    [glue.sch, pda6502v2.sch]
2017-04-11 hardware: chipset schematic; XC2C128A-VQ100
    [chipset.sch, pda6502v2.sch]
2017-04-11 hardware: chipset hierarchical pins
    [chipset.sch, pda6502v2.sch]
2017-04-14 hardware: CPU sub-schematic.
    [chipset.sch, cpu.sch, pda6502v2.sch]
2017-04-28 hardware: schematic for 2 x 6522 VIA/GPIO.
    [chipset.sch, cpu.sch, gpio.sch, pda6502v2.sch]
2021-04-10 Delete WIP KiCad schematic from April 2017
    It had some nice starts, with heirarchical sheets for 6522 GPIO etc, but
    was based on CPLD rather than FPGA, and had issues with latest KiCad
    versions/libraries which aren't really worth resolving.
    [chipset.sch, cpu.sch, gpio.sch, pda6502v2.kicad_pcb, pda6502v2.sch]
2021-04-10 kicad: new empty project
    [pda6502v2.kicad_pcb, pda6502v2.sch]
2021-04-11 kicad/.gitignore from github/gitignore/KiCad.gitignore
2021-05-01 KiCad schematic has 6502, 6522, 2 x 32 KiB RAM.
    [pda6502v2.kicad_pcb, pda6502v2.sch]
2021-05-29 README updates; keeping up with changed during schematic capture etc.
2021-05-29 Lots of progress on schematic, some PCB part placement.
    [pda6502v2.kicad_pcb, pda6502v2.sch]
2021-06-03 WIP: remove PMOD. SMD LDO. Layout updates.
    [pda6502v2.kicad_pcb, pda6502v2.sch]
2021-06-03 Dual 6522 VIA; PCB layout progress.
    [pda6502v2.kicad_pcb, pda6502v2.sch]
2021-06-03 Headers for SPI and EXT (FPGA expansion)
    [pda6502v2.kicad_pcb, pda6502v2.sch]
2021-06-04 ARMSID instead of second 512 KiB RAM
    [pda6502v2.kicad_pcb, pda6502v2.sch]
2021-06-04 Rearranged FPGA pin allocations for easier routing
    [pda6502v2.kicad_pcb, pda6502v2.sch]
2021-06-04 Deleted unused (hopefully?) nets
    [pda6502v2.kicad_pcb]
2021-06-05 Routing begins; FPGA to EXT & SPI headers.
    [pda6502v2.kicad_pcb, pda6502v2.sch]
2021-06-05 FPGA EXT/SPI routing tweaks, UART moved down/right
    [pda6502v2.kicad_pcb, pda6502v2.sch]
2021-06-05 Routing WIP; UART
    [pda6502v2.kicad_pcb, pda6502v2.sch]
2021-06-06 Routing WIP: UART header, caps/resistors etc.
    [pda6502v2.kicad_pcb]
2021-06-07 LDO placement/routing, XO HandSolder footprint, etc.
    [pda6502v2.kicad_pcb, pda6502v2.sch]
2021-06-07 Routing; power, ground vias, UART/osc, reset button/header, etc.
    [pda6502v2.kicad_pcb, pda6502v2.sch]
2021-06-16 BLINKEN and other minor tweaks
    [pda6502v2.kicad_pcb, pda6502v2.sch]
2021-06-16 BLINKEN routed
    [pda6502v2.kicad_pcb]
2021-06-17 routing WIP: mostly ICSP to flash, a bit of BLINKEN
    [pda6502v2.kicad_pcb]
2021-06-17 routing/placement; SID, FPGA, UART shifted away from centre.
    [pda6502v2.kicad_pcb]
2021-06-17 more routing; SID connector, misc power etc.
    [pda6502v2.kicad_pcb]
2021-06-23 Lots of routing. Nearly done, but getting tight.
    [pda6502v2.kicad_pcb, pda6502v2.sch]
2021-06-23 ARMSID routing improvements; fewer vias, straighter tracks.
    [pda6502v2.kicad_pcb]
2021-06-23 ARMSID X/Y caps moved from IC to headers; making room.
    [pda6502v2.kicad_pcb]
2021-06-23 More routing, more stuck.
    [pda6502v2.kicad_pcb]
2021-06-23 More routing. D[0..7] etc.
    [pda6502v2.kicad_pcb, pda6502v2.sch]
2021-07-10 PCB 100% routed
    [pda6502v2.kicad_pcb, pda6502v2.sch]
2021-07-31 Track routing tweaks / optimisation.
    [pda6502v2.kicad_pcb]
2021-07-31 Cleanup (auto): Merge overlapping segments
    [pda6502v2.kicad_pcb]
2021-07-31 Cleanup (auto): Delete dangling tracks
    [pda6502v2.kicad_pcb]
2021-07-31 Fill All Zones (small change after auto-cleanups)
    [pda6502v2.kicad_pcb]
2021-08-08 Lots of minor/aesthetic PCB work.
    [pda6502v2.kicad_pcb]
2021-08-12 PA initials and "v2" on PCB, plus some tweaks.
    [pda6502v2.kicad_pcb, pda6502v2.sch]
2021-08-12 gerbers as sent for production
    [pda6502v2-B_Cu.gbl, pda6502v2-B_Mask.gbs, pda6502v2-B_SilkS.gbo, pda6502v2-Edge_Cuts.gm1, pda6502v2-F_Cu.gtl, pda6502v2-F_Mask.gts, pda6502v2-F_SilkS.gto, pda6502v2.drl]
2021-08-29 kicad: post-fab changes (mostly/entirely R/C value updates?)
    [pda6502v2.kicad_pcb, pda6502v2.sch]
2021-08-29 bifröst: early WIP on boot EEPROM→RAM.
2021-09-07 PCB tweaks (R26/R27 swap? other small things?) and Errata.
    [pda6502v2.kicad_pcb]
2021-09-07 eeprog: program to write FPGA/6502 data to SPI EEPROM via ICSP.
    Currently just an aspirational README.
2021-09-07 eeprog: write & read "hello" to EEPROM over USB/FTDI/SPI bitbang.
2021-09-09 eeprog: SPI/FTDI code extracted to spi.{c,h}
2021-09-10 eeprog: status/upload/download/verify/help, and wiring change.
2021-09-17 eeprog: help text pin mapping fixed.
2021-09-25 eeprog: BITMODE_RESET during spi_deinit
    Intended to release the SPI bus outputs so that another SPI master
    (FPGA) can drive them. Not sure if it worked.
2021-09-25 eeprog: entire FTDI FT230X implementation deleted
    Pending replacement with an Arduino equivalent
2021-09-25 eeprog: Arduino version of EEPROM programmer
2021-09-25 bifröst: BLINKEN LEDs register flipped so MSB is left-most.
2021-09-25 bifröst: bifrost.v with testbench, not doing anything much yet.
    Attempting to put SPI outputs into tri-state so that eeprog can drive
    them, but yosys doesn't (fully?) support tri-state..?
    Meanwhile, eeprog has learned to hold RESET active during SPI
    operations.
    [bifrost.pcf, bifrost.v, bifrost_tb.v]
2021-09-27 bifröst: adec.v (address decoder) maps RAM/SID/VIA1/VIA2/UART.
2021-09-28 bifröst: boot module copies EEPROM to RAM
    EEPROM data from 0x080000–0x081FFF (8 KiB)
    is copied to 0xE000–0xFFFF in RAM.
    Not yet integrated with main bifrost module, nor tested on real
    hardware, but the testbench waveform using 25AA512 EEPROM verilog model
    looks good in GTKwave.
2021-09-29 bifröst: boot.v fixes; offset width, leave outputs in Hi-Z.
    [boot.v, boot_tb.v]
2021-09-29 bifröst: boot registers all outputs
    Otherwise warning (and synthesis failure?) occur:
    Warning: wire '\flash_sck' is assigned in a block
    [boot.v]
2021-10-02 bifröst: lots of fixes; seems to testbench & synth okay
    [adec.v, bifrost.v, bifrost_tb.v, blinken.v, boot.v, boot_tb.v]
2021-10-04 eeprog: cmd_write prints ? to serial if Serial.read() fails
    [eeprog.ino]
2021-10-04 bifröst: divide 6502 clock down to 31,250 Hz for now.
2021-10-04 bifröst: reset 6502 on boot using air wire on EXT0
    [bifrost.v, boot.v, eeprog.ino]
2021-10-07 bifröst: busen comment corrected
    [boot.v]
2021-10-07 os/nop.c: assemble a nop loop for 0xE000..0xFFFF
2021-10-07 bifröst: nop.v is a minimal top-level NOP-loop module.
    Intended to test with a logic analyzer that BIFRÖST is able to provide a
    fixed data byte and leave the address lines in Hi-Z tristate so that the
    6502 can drive address and cycle through NOPs. It worked.
    [nop.pcf, nop.v, nop_tb.v]
2021-10-08 bifröst adec: only ram_cs guarded by clock=HIGH
    GARTHWILSON reckon's RAM should be guarded by PHI2.
    Seems like clocked devices (6522 etc) don't need this.
    Hopefully that applies to SID/ARMSID too (it's clocked).
    http://forum.6502.org/viewtopic.php?t=511
2021-10-08 bifröst: lots of debugging; 6502 is working!
    eeprog upload bifröst/bifrost.bin /dev/cu.usbmodem144102 0
    eeprog upload os/nop.bin /dev/cu.usbmodem144102 0x80000
    Successfully loads 8 KiB nop.bin into $E000 and enters NOP loop.
    (with JMP $E000 just before it hits the vectors at $FFFA)
    Verified by running slow 15 kHz clock, assigning upper 8 bits of ADDR to
    BLINKEN, and observing the lower 5 bits of BLINKEN binary counting as it
    loops from $E000 to $FFF9.
    FPGA start-up and EEPROM-to-RAM observed with logic analyser decoding
    SPI data.
2021-10-08 README.md Errata updated; RESET for FPGA/6502 coupled.
2021-10-09 bifröst: clock divided to 1 MHz, was 15,625 Hz for testing.
2021-10-09 eeprog: disable RESET during writes (messes with SPI?)
    With RESET _not_ being held during reset, ICSP writes by eeprog are
    succeeding while FPGA is connected. I guess this means the FPGA SPI
    lines are correctly tri-stating to Hi-Z now.
    [eeprog.ino]
2021-10-09 bifröst: blinken start-up animation faster/simpler.
    Just a single LED at a time, moving left-to-right once.
2021-10-09 eeprog: 'reset disable' in help text, and actually works.
    [eeprog.ino]
2021-10-09 eeprog: add missing SPI.beginTransaction to cmd_write verification
    [eeprog.ino]
2021-10-09 eeprog: fix CRLF for cmd_write want/got message
    [eeprog.ino]
2021-10-09 eeprom_write_enable: missing SPI boundary
    Hopefully this gets the clock back into a valid state.
    [eeprog.ino]
2021-10-09 bifröst: boot uses 1 MHz clockout, not 4 MHz (was failing)
    [bifrost.v]
2021-10-12 bifröst / os: reduce os.rom to 1 KiB for faster dev iteration
    1 KiB transfers to/from EEPROM and into SRAM faster, with lower chance
    of write errors. Can increase it again in future if it gets too cosy.
    [boot.v]
2021-10-12 bifröst: fix adec; enable RAM during HIGH clock, not LOW!
    I was attempting to heed this advice, but flipped the logic:
    > Notice in the diagram above that Φ2 is involved with the RAM select
    > but nothing else. You must have a way to make sure RAM cannot be
    > written when Φ2 is low!
    — http://wilsonminesco.com/6502primer/addr_decoding.html
    [adec.v]
2021-10-12 bifröst: drive irq based on IRQ inputs, pull-up on uart_irq
    SC28L92 UART is the only chip with open-drain IRQ that needs a pull-up.
    W65C22S drives high & low IRQ.
    iCE40 HX has optional pull-ups on IO pins, which can be coaxed into
    existence by yosys using manually instantited SB_IO constructs, but it
    seems they can also be set more easily by nextpnr in the PCF file.
2021-10-13 os: assemble with --cpu 65C02 to use newer instructions
2021-10-13 os: bounce blinken back and forth using VIA2 timer interrupts.
2021-10-15 bifröst: uart_irq, uart_rdn, uart_wrn connected.
    uart_rdn and uart_wrn are verified working.
    uart_irq hasn't been verified yet, and relies on the pull-up specified
    in the PCF file, which apparently is a thing that nextprn-ice40 and the
    iCE40HX4K support, but I'll believe it when I see it. That said, it
    hasn't triggered any spurious interrupts during a fair bit of testing,
    so maybe it's working.
2021-10-15 os: UART code, TX a welcome/prompt, echo RX chars.
    Welcome to pda6502v2
    > hello world
    Doesn't do anything yet, just trying out simple, non-interrupt-driven
    UART operation.
2021-10-17 eeprog: verify/retry sector erases
    (Didn't help for the common case I'm seeing while the FPGA is connected;
    every attempt fails).
    [eeprog.ino]
2021-10-17 os: unused code deleted from uart.s
2021-10-25 bifröst & os: blinken timer shifted to VIA1
    VIA1_IRQ to FPGA solder joint is fixed, so it can now be used. This
    change successfully tests it working as a timer. It also refactors the
    via.s constants to separate the 16-bit base address of each chip from
    the 4-bit register addresses therein.
    [bifrost.v]
2021-10-26 os: uart doesn't set BLINKEN
2021-10-26 os: UART echo via interrupts, not polling
2021-10-26 os: lower-case ca65 assembler directives (.proc, .endproc, .byte)
2021-10-26 os: UART interrupt-reads into ring buffer; echo from that.
2021-10-29 os: UartRxInterrupt stops pulling from FIFO when full
2021-10-29 os: rewrite unused delayXY from uart.s to delay100ms in time.s
2021-10-30 os: uart.s documentation/comments improved.
2021-10-30 os: UartRxBufRead blocks/polls if carry bit set.
2021-10-30 os: delete unused UartGetcBlocking
2021-11-04 os: uart txbuf (not yet used)
    This code is probably good, as it closely mirrors the rxbuf code.
    However I currently can't get the associated interrupt-on-TX-ready code
    working to flush this txbuf to the UART FIFO.
    Committing this probably-good subset of code for now to keep the working
    changeset smaller while debugging.
2021-11-04 os: interrupt-driven UART TX txbuf is working
2021-11-05 os: UartEcho uses UartTxBufWrite; UartPutc deleted.
2021-11-05 os: UartHello masks IRQ during repeated UartTxBufWrite
    Otherwise each character triggers an interrupt, rather than waiting
    until the entire message is in txbuf.
2021-11-06 bifröst: 6502 reset moved from ext[0] to ext[15]
    The fixup wire is soldered on the underside of the board now, rather
    than alligator-clipped across the top. It seemed to make more sense to
    use the last EXT pin, rather than the first, partly because its on the
    inner side of the connector.
    [bifrost.v]
2021-11-06 os: shell.s early WIP
    - Welcome message
    - Prompt "> " on each line
    - Backspace handling
    - all commands are command not found
    Example shell session over UART:
    command not found
    >
    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
2021-11-09 os: WIP game of life; rendering a grid to ASCII/UART.
2021-11-11 os: UART at 115,200 baud, was 9600
2021-11-14 os: ctrl-c user interrupt; Game of Life is interruptible
2021-11-21 bifröst: spi module; testbench & synthesis okay, TODO: integrate.
2021-11-23 bifröst: SPI module part of bifröst 8-bit register space.
2021-11-23 bifröst: hardware SPI!
2021-11-23 os: shell has spi command, sends greeting over BIFRÖST SPI
2021-11-23 bifröst: spi handles bigger clockdiv.
    Previously, with 6502 at 1 MHz, SPI output was sending corrupted
    nine-bit bytes. I think this is because the write-to-SPI-register was
    being handled multiple times by the @(posedge clock_spi).
    There's probably a better way to avoid conflicting drivers of spi_buf
    and spi_bits while still using @(posedge clock_sys) for the
    register-writing, but I don't know what. So, I'm tracking the previous
    state of that clock to simulate posedge tracking.
    It seems to have worked, under non-rigorous testing.
    [spi.v, spi_tb.v]
2021-11-30 os: SID tune VIA2 IRQ-driven, works but very sketchy WIP.
    e.g. game of life doesn't render properly while tunes are playing.
    Conflicing interrupts? Too much time spent in interrupts? UART TX buffer
    overrun while VIA/SID IRQ being handled? Not sure yet.
2021-12-01 os: UartEcho deleted, unused
2021-12-13 os: uart.s code comment fixes/improvements.
2022-06-23 emu: some simple println! debug output
2022-06-24 emu: Assembler (WIP); assemble & run NOP,NOP,NOP,INX,JMP loop.
2022-06-26 emu: Assembler has IllegalAddressMode error via Result<T, Error>
    [asm.rs, main.rs]
2022-06-26 emu: Assembler labels, org, listing, LDX, refactoring, etc.
2022-06-26 emu: fix asm tests, and some verbose syntax repetition.
    [asm.rs, isa.rs]
2022-06-27 emu: isa tidied, rename Instruction → Opcode
2022-06-29 emu: fix clippy lint warnings
    Auto-fixed with:
    cargo clippy --fix -- -A clippy::upper_case_acronyms
    Ignoring these for now:
    warning: name `ADC` contains a capitalized acronym
    help: consider making the acronym lowercase, except the initial letter: `Adc`
    [asm.rs]
2022-06-29 emu: clippy::upper_case_acronyms lint fix (CamelCase mnemonics)
    [asm.rs, cpu.rs, isa.rs]
2022-06-29 emu: Debug for Opcode upper-cases Mnemonic (Nop→NOP)
2022-07-01 emu: Assembler listing displays upper-case Mnemonics
2022-07-01 emu: Assembler.print_listing to easily tap into method chains
2022-07-01 emu: INX ZP mode implemented, tested. Cpu tests use Assembler now.
2022-07-01 emu: main uses Assembler.print_listing()
2022-07-18 emu: ADC all modes, better SR register support.
    Overflow bit in SR still TODO.
2022-07-19 emu: ADC sets Carry bit correctly.
    [cpu.rs]
2022-07-19 emu: W65C02S manual §3.1 Reset says SR=xx1101xx
    [cpu.rs]
2022-07-19 emu: CPU test moved from src/cpu.rs to tests/cpu.rs
    These are integration tests; they're using the CPU with a real Bus,
    Assembler etc.
2022-08-25 emu: BCC implemented (TODO: asm handle abs→rel)
2022-10-27 kicad: add kicad_pro, kicad_sch & rescue files
    I can only guess what these are, they're sitting around as untracked
    changes, may as well commit them.
    [pda6502v2.kicad_sch]
2022-11-22 emu: asm listing() reports error type in crash message
    [asm.rs]
2023-04-22 emu: LSR fixed to set carry bit in Accumulator mode
    [cpu.rs, main.rs]
2023-04-22 emu: RTI implemented (and BRK return addr fixed)
    [asm.rs, cpu.rs, main.rs]
2023-04-30 emu: BRK & RTI corrected
    As discovered via:
    https://github.com/TomHarte/ProcessorTests/tree/main/6502
    [cpu.rs]
2023-04-30 emu: test & fix address modes around page boundaries
    [cpu.rs]
2023-06-28 emu: refactor so Cpu doesn't ref/own Bus
    [cpu.rs, main.rs]
2023-06-28 emu: don't print each opcode executed
2023-06-28 emu: new mon::Monitor prints cpu state and next opcode
    This should eventually become an interactive monitor/debugger
2023-10-14 kicad: 6502-kicad-library updated
    I should perhaps make this a git submodule, or just vendor it, or just
    copy in the parts I need.
2023-10-14 kicad: migrate pda6502v2 symbol library from .lib to .kicad_sym
2023-10-14 kicad: .gitignore updated from github/gitignore/KiCad.gitignore
2023-10-14 kicad: schematic format version 20211123->20230121 (KiCad 7.0)
    [pda6502v2.kicad_sch]
2023-10-14 kicad: PCB format version 20171130->20221018 (KiCad 7.0)
    [pda6502v2.kicad_pcb]
2023-10-15 kicad: schematic Electrical Rules Checker fixes
    Use updated 6502-kicad-library symbols, including their 6522 instead of
    our own. The symbol size/pins etc moved around, schematic adjusted.
    Use new built-in capacitor symbols instead of rescued olf CP-Device.
    [pda6502v2.kicad_sch]
2023-10-15 kicad: more schematic Electrical Rules Checker fixes
    Updated symbols from pda6502v2 library; I think these updates were
    no-ops, the library symbols hadn't really changed, but had been migrated
    from older KiCad?
    Also a no-op Diode updated.
    [pda6502v2.kicad_sch]
2023-10-16 kicad: schematic Electrical Rules Checker all fixed
    Mostly involved unstacking invisible duplicate power pins on the LM3030
    vreg, because the labels (IN1, IN2) of the invisible power pins get
    inherited by the net connected to +3V3 which causes the net to have
    multiple names; a harmless warning.
    The four GND pins can stay invisible-stacked because they have the same
    name as the GND net.
    [pda6502v2.kicad_sch]
2023-10-16 kicad: PCB DRC fixes; only require 1 spoke of thermal relief
    Various pads only have space for a single spoke to the copper GND fill,
    and that's fine.
    There's still various warnings.
    [pda6502v2.kicad_pcb]
2023-10-16 kicad: DRC: ignore "Footprint .. does not match copy in library .."
    Many footprints are edited on the board for aesthetics etc.
    I believe this is a new DRC rule in KiCad 7 or maybe 6.
2024-05-07 emu: run actual os.rom code (RAM only)
    Reaches an infinite loop polling waittxbuf inside UartTxStr which makes
    sense, because the UART chip isn't mapped into the bus.
2024-05-10 emu: colour monitor output, and beginnings of UART
2024-06-02 emu: CMP carry bit bug fixed
    [cpu.rs]
2024-06-02 emu: working! interrupts, UART as UDP port 6502, SID random for GoL.
