pda/pda6502v2/(notices)

Notices in the files:
bifröst/models/25AA512.v:
This information is distributed under license from Young Engineering.
COPYRIGHT (c) 2009 YOUNG ENGINEERING
ALL RIGHTS RESERVED
